covid19murcia/visera-covid19-diy/README.md

# visera-covid19-diy
Esta es una visera para ayudar a evitar salpicaduras que propaguen el covid19

En la carpeta diseño tenemos un diseño stl y en Freecad.
