covid19murcia/visera-covid19-diy/v0.4 con cintas.PNG

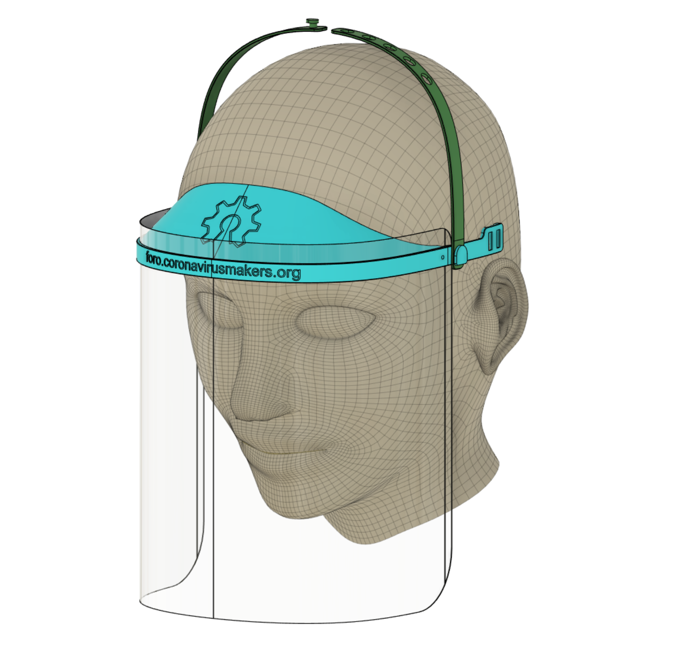
v0.4 con cintas.PNG
