covid19murcia/visera-covid19-diy/diseños/version03/Visera_3.5.1b_patas_traseras_recortadas.stl

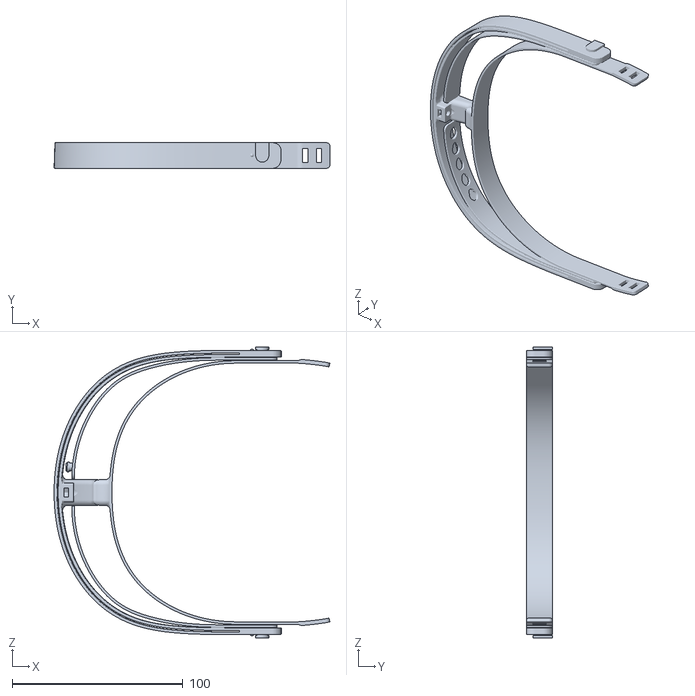
[picture p2: CAD file, 2020-03-18]
diseños/version03/Visera_3.5.1b_patas_traseras_recortadas.stl
161.5 x 15.0 x 170.4
