covid19murcia/visera-covid19-diy/diseños/version0.4/Fijador láminas finas/Fijador laminas finas 500um.stl

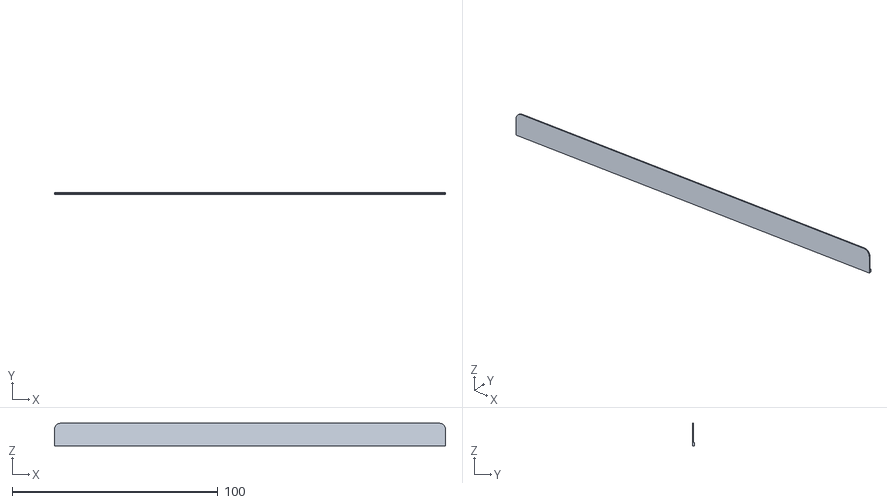
[picture p3: CAD file, 2020-03-21, an earlier design]
diseños/version0.4/Fijador láminas finas/Fijador laminas finas 500um.stl
190.0 x 1.20 x 11.0
