covid19murcia/visera-covid19-diy/diseños/version0.4/Visera_Fija_Cerrado_v0.4.stl

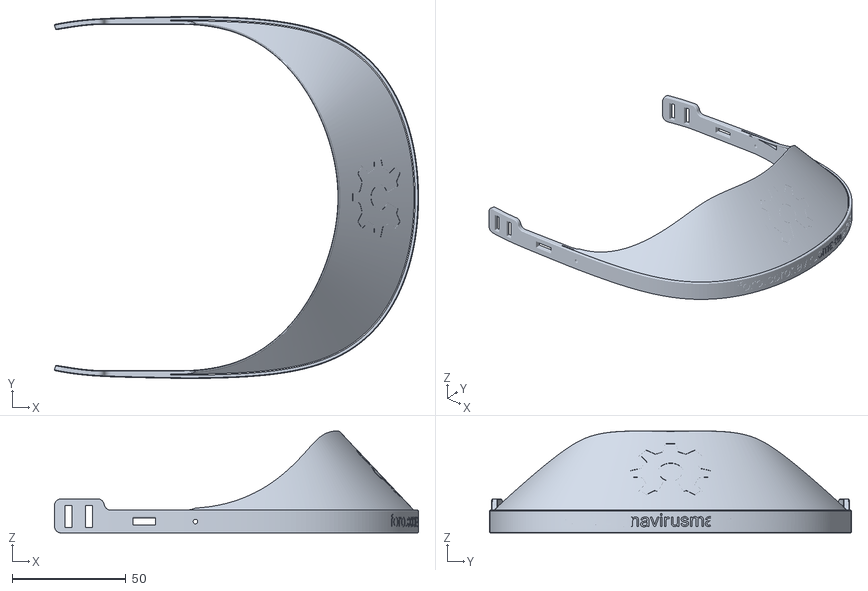
[picture p4: CAD file, 2020-03-21, an earlier design]
diseños/version0.4/Visera_Fija_Cerrado_v0.4.stl
159.9 x 159.0 x 44.8
