covid19murcia/visera-covid19-diy/diseños/version0.5/Visera_Plana_con_cierre_y_ventilacion_0.5.stl

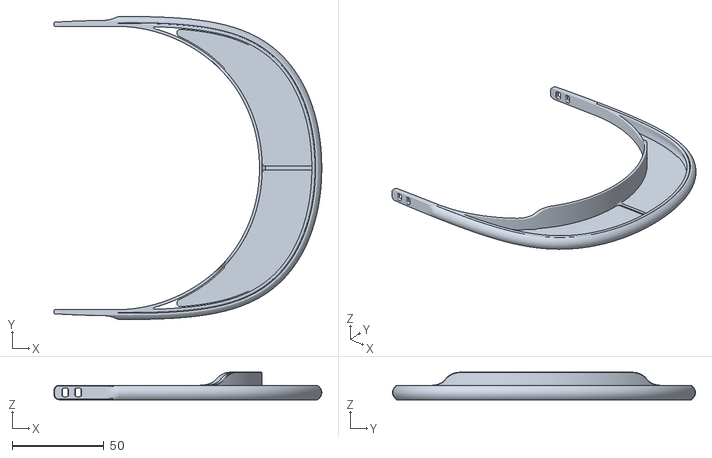
[picture p5: CAD file, 2020-03-23, an earlier design]
diseños/version0.5/Visera_Plana_con_cierre_y_ventilacion_0.5.stl
145.6 x 164.8 x 15.0
