covid19murcia/visera-covid19-diy/diseños/version0.4/Fijador láminas finas/Fijador laminas finas 600um.stl

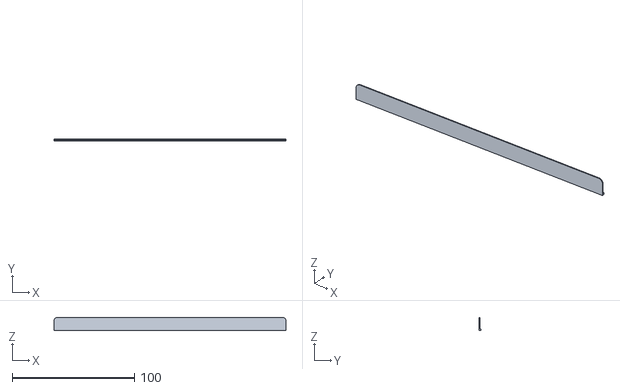
[picture p6: CAD file, 2020-03-21, an earlier design]
diseños/version0.4/Fijador láminas finas/Fijador laminas finas 600um.stl
190.0 x 1.50 x 11.0
