covid19murcia/visera-covid19-diy/(list of files, cad)

Other CAD files:
diseños/version0.4/Fijador láminas finas/Fijador laminas finas 400um.stl
diseños/version0.4/Fijador láminas finas/Fijador laminas finas 300um.stl
