covid19murcia/visera-covid19-diy/instrucciones/Visera Fija Cerrada rev0.4.pdf

# Visera Fija Cerrada rev0.4

### Compatible con Acetato A4 entre 0.18 y 0.6mm

### Dos variantes:

1. Totalmente fija | 2. Con cintas superiores móviles

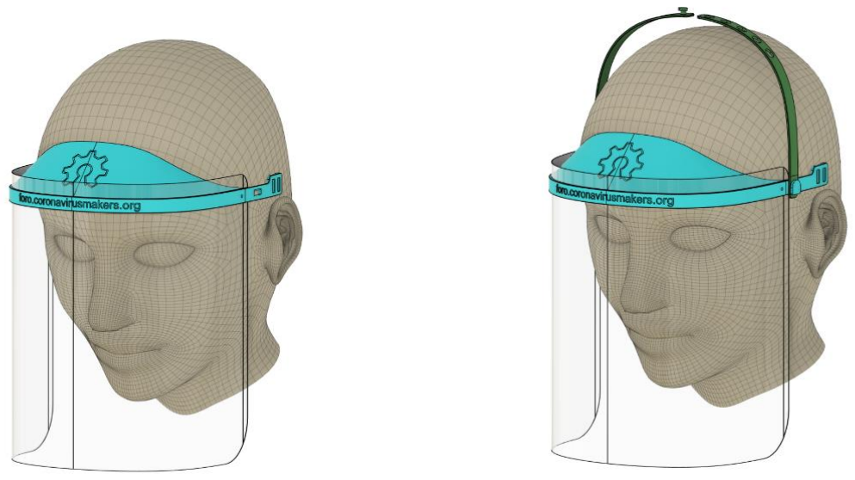
[picture p7: figure]
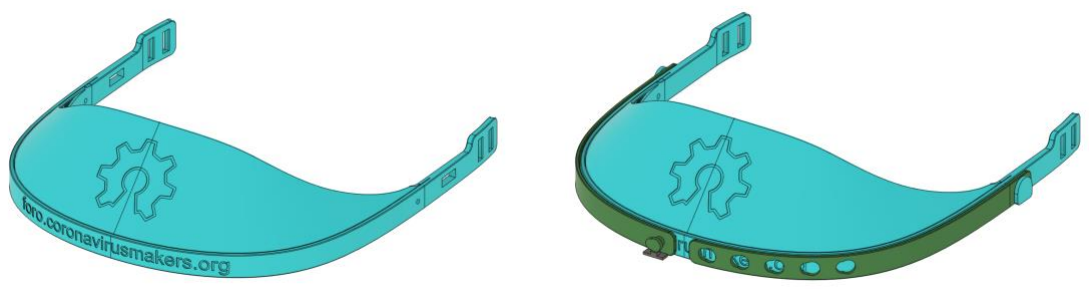
[picture p8: figure]

1h30min de impresión 30g | 1h50min de impresión 37g

Parámetros de impresión:

- Diámetro del Nozzle: 0.4mm
- Altura de capa: 0.28mm
- Relleno: 50%
- Tipo de relleno: Rejilla
- Capas superiores: 4
- Capas inferiores: 2
- Sin soportes

Fijación de la lámina en la visera:

- Para láminas de 0.6 no hace falta fijación extra.
- Para láminas finas (0.24, 0.18mm) usar archivo adjunto “Fijador láminas finas”. Este modelo viene en distintos espesores para compensar los distintos grosores de lámina.
