covid19murcia/visera-covid19-diy/instrucciones/Manual de ensamblaje mascara protectora v03.pdf

# Manual de impresión y ensamblaje mascara protectora

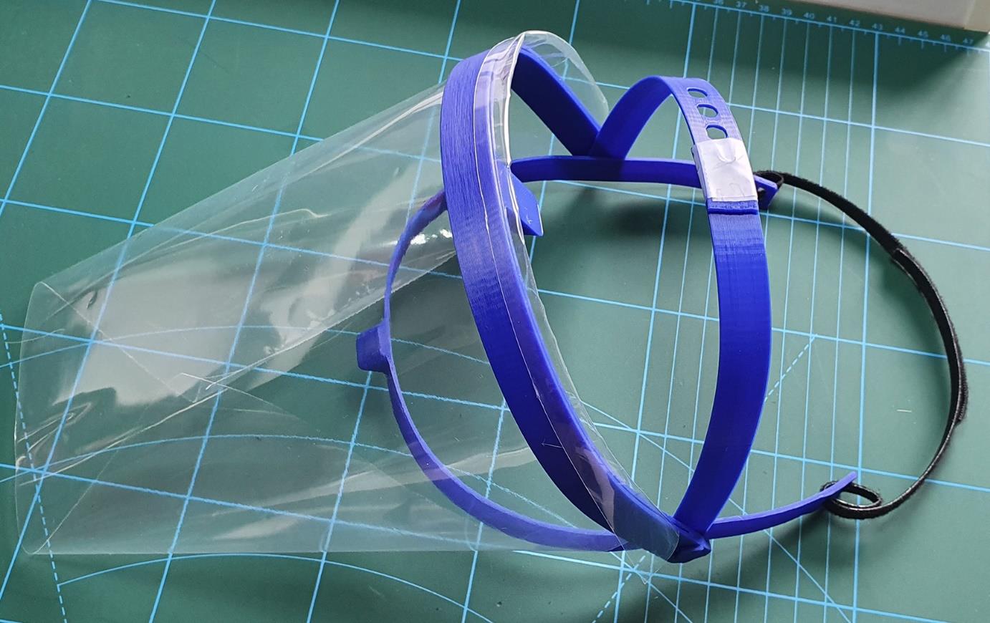
[picture p9: figure]

# Datos del Documento

Autor: | @YKA3D
Revisor: | @kermithenson
Fecha de publicación: | 18/03/2020

Observaciones:
Para comenzar a fabricar es necesario que la máquina esté correctamente calibrada. Una vez calibrada, se deberá llevar a cabo una prueba de tolerancia.

Test: https://www.thingiverse.com/thing:1662342

# Hoja de Cambios

Fecha | Versión | Autor | Cambios
18 de marzo de 2020 | v.0.1 | @YKA3D | Creación del documento
18 de marzo de 2020 | V.0.2 | @YKA3D | modificación fijación trasera
18 de marzo de 2020 | V.0.3 | @kermithenson

# Versión STL

Fecha | Versión | Autor | Cambios
18 de marzo de 2020 | v.3.5 | @YKA3D | Creación del documento

# Índice

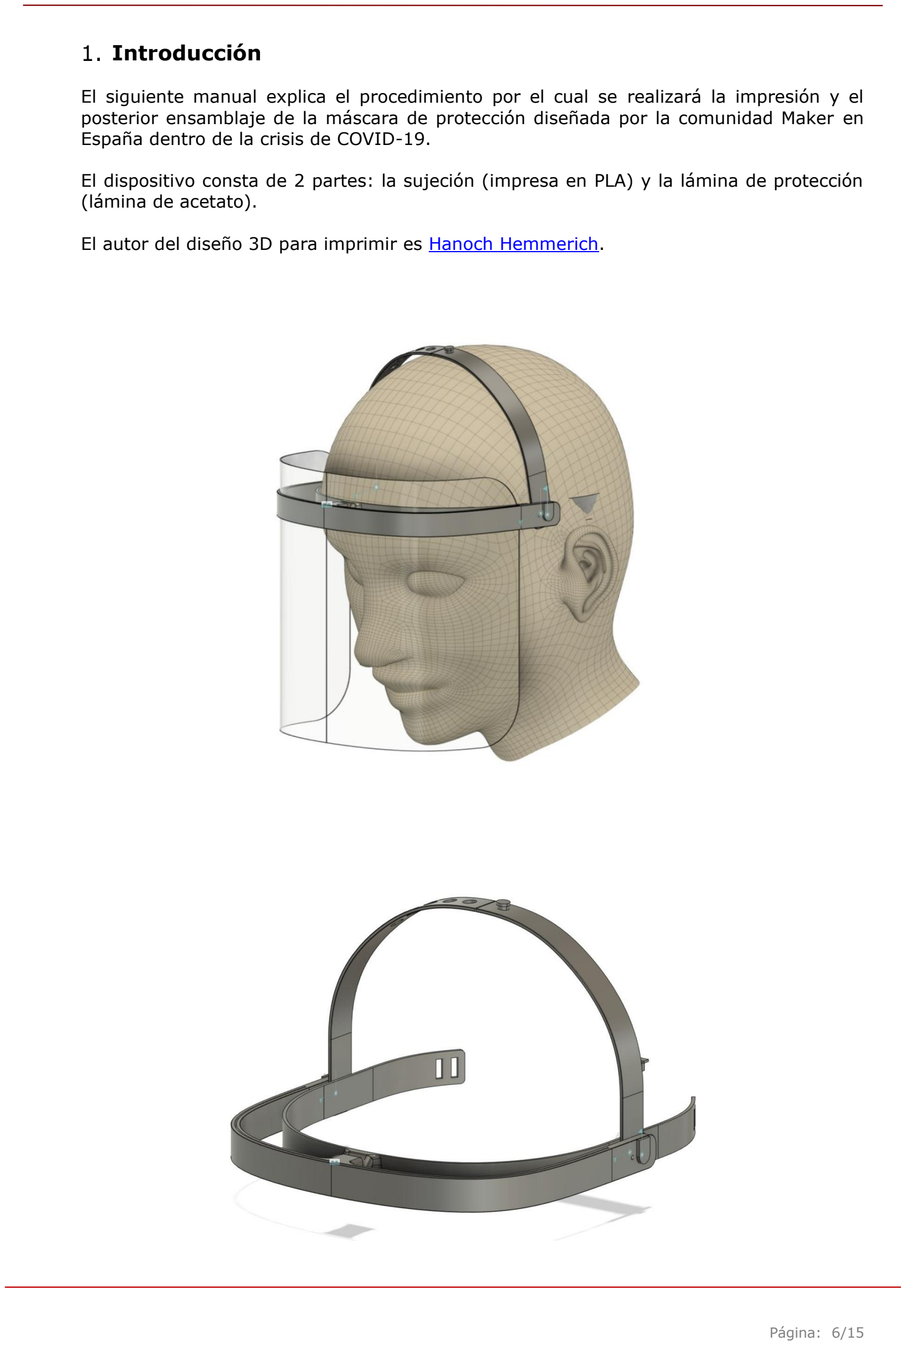
[picture p10: page 4]

### Introducción

El siguiente manual explica el procedimiento por el cual se realizará la impresión y el posterior ensamblaje de la máscara de protección diseñada por la comunidad Maker en España dentro de la crisis de COVID-19.

El dispositivo consta de 2 partes: la sujeción (impresa en PLA) y la lámina de protección (lámina de acetato).

El autor del diseño 3D para imprimir es Hanoch Hemmerich. (https://www.thingiverse.com/HanochH/about)

### Parámetros de impresión

El archivo para su impresión se puede descargar desde el siguiente enlace:

https://www.thingiverse.com/thing:4228123

- Diámetro del Nozzle: 0.4mm
- Altura de capa: 0.28mm
- Relleno: 50%
- Capas superiores: 4
- Capas inferiores: 2
- Flujo: 80%
- Sin soportes
- Velocidad de impresión:
- Perímetros: 80mm/s
- Perímetros pequeños: 80mm/s
- Perímetros externos: 80mms/s
- Relleno: 80mms/s
- Relleno solido: 80mms/s
- Relleno solido superior: 80mm/s
- Puentes: 80mm/s
- Relleno: 80mm/s
- Recorrido: 180mm/s

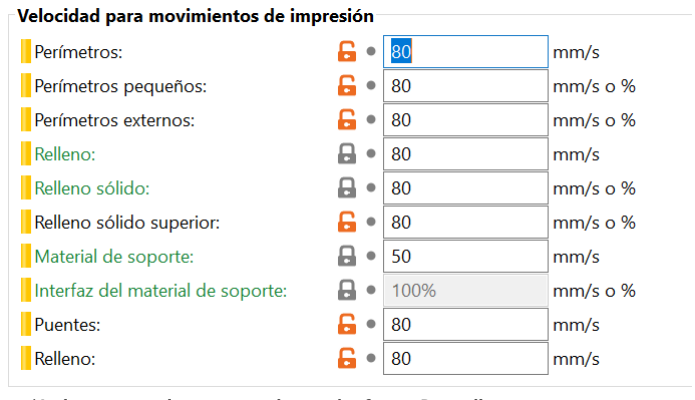
[picture p11: figure]

*La imagen anterior corresponde con el software Prusaslicer

Material impresión: PLA

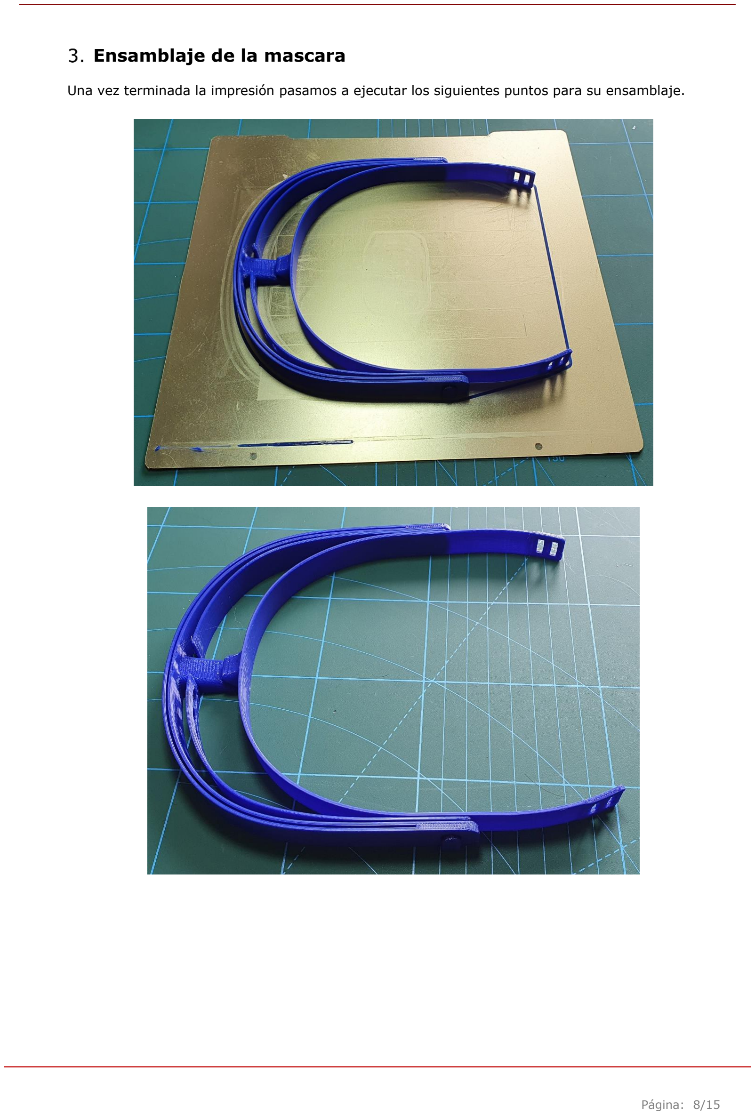
[picture p12: page 6]

### Ensamblaje de la mascara

Una vez terminada la impresión pasamos a ejecutar los siguientes puntos para su ensamblaje.

### Eliminación de soportes

El archivo ya viene preparado con un soporte para el remache que nos ayudara a fijar la correa superior para la cabeza.

Solo es necesaria la eliminación del pequeño soporte que se muestra en la siguiente imagen.

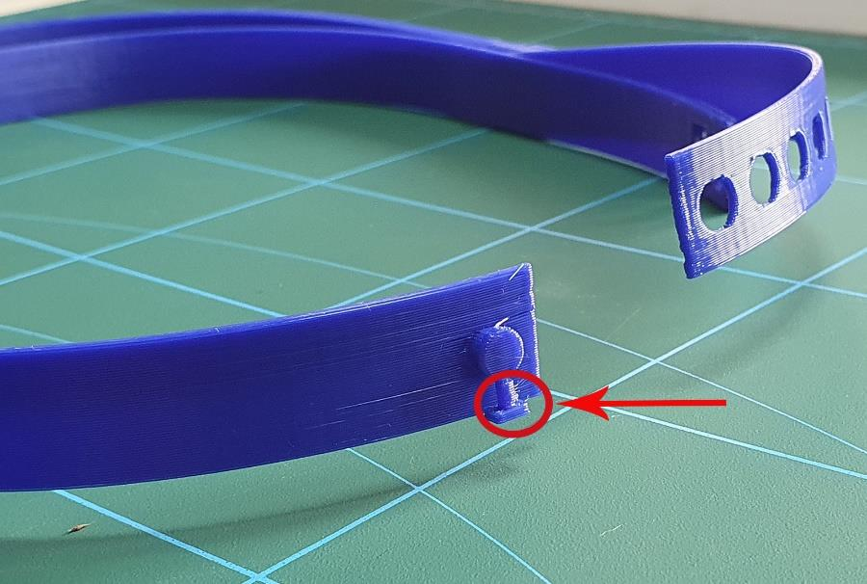
[picture p13: figure]

### Ajuste de correa para la cabeza

Una vez retirado el porte ajustamos la correa a la medida deseada

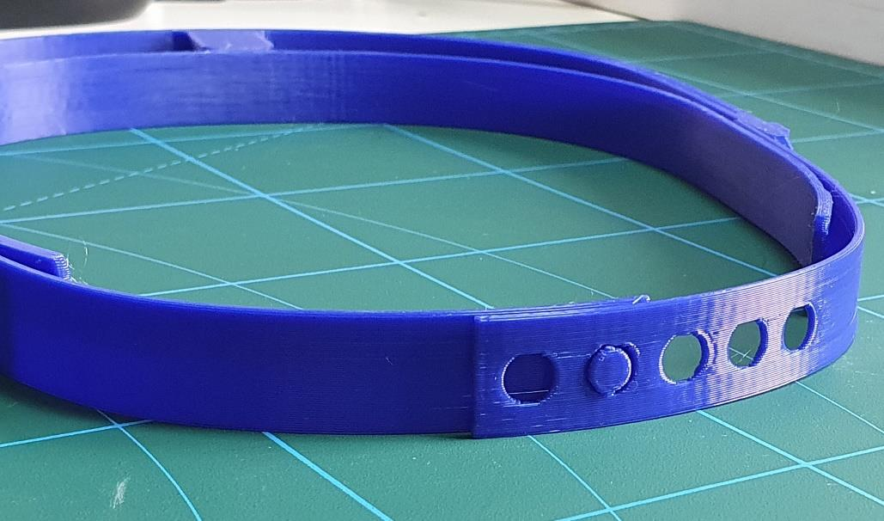
[picture p14: figure]

Cuando tengamos ajustada la correa superior para asegurarla es recomendable aplicar un poco de celo, esparadrapo, cinta, en definitiva, lo que se tenga a mano para sujetar con firmeza la correa superior.

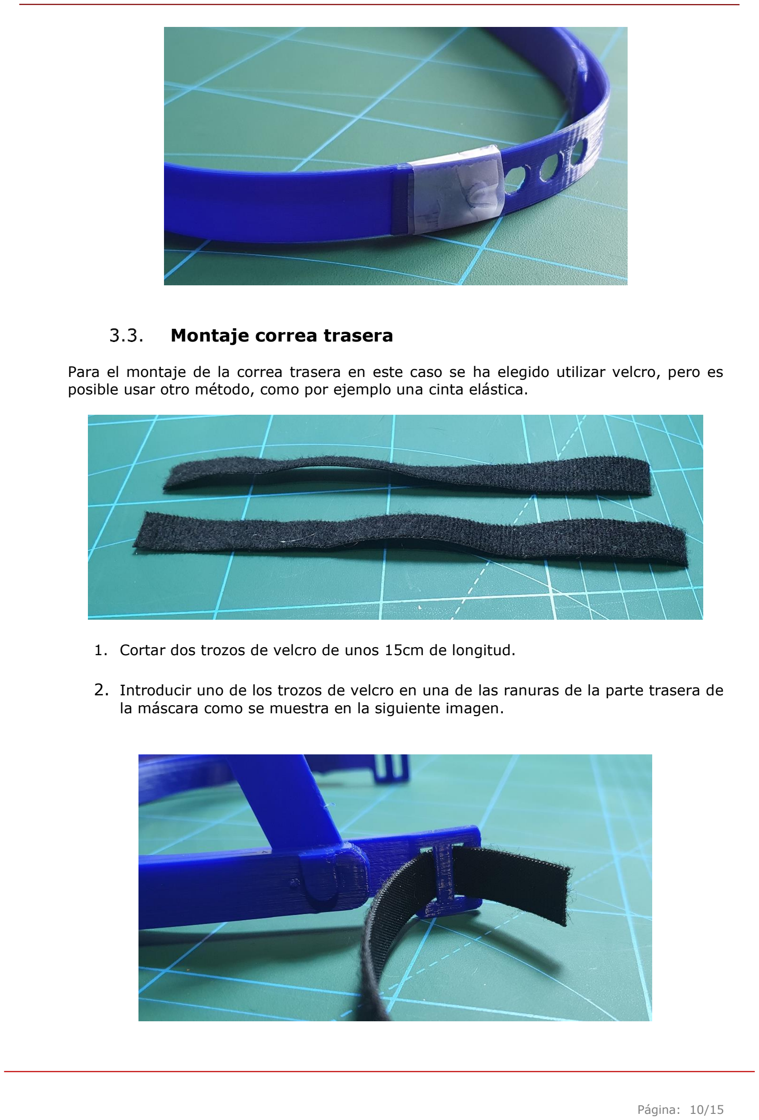
[picture p15: page 8]

### Montaje correa trasera

Para el montaje de la correa trasera en este caso se ha elegido utilizar velcro, pero es posible usar otro método, como por ejemplo una cinta elástica.

1. Cortar dos trozos de velcro de unos 15cm de longitud.
2. Introducir uno de los trozos de velcro en una de las ranuras de la parte trasera de la máscara como se muestra en la siguiente imagen.

3. Girar el extremo más corto del velcro para crear un bucle y que quede fijado en una de las patillas, tal como se muestra en la siguiente imagen. (Importante que la parte del velcro suave quede hacia afuera)

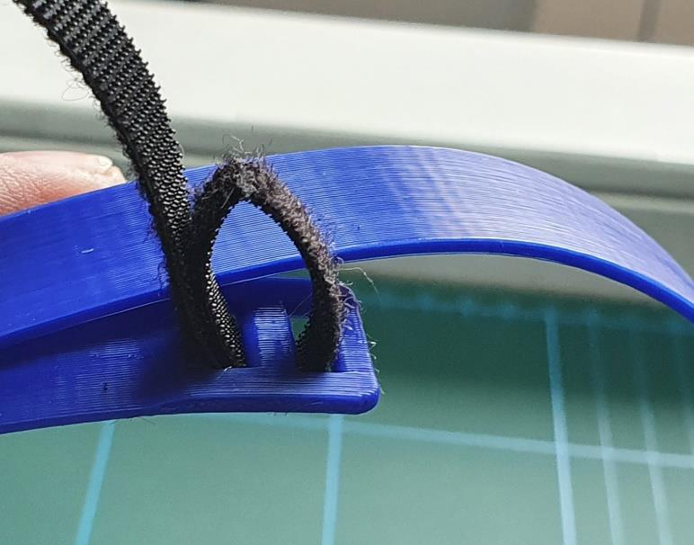
[picture p16: figure]

4. Girar un poco el velcro para que dé un par de vueltas y quede bien fijado

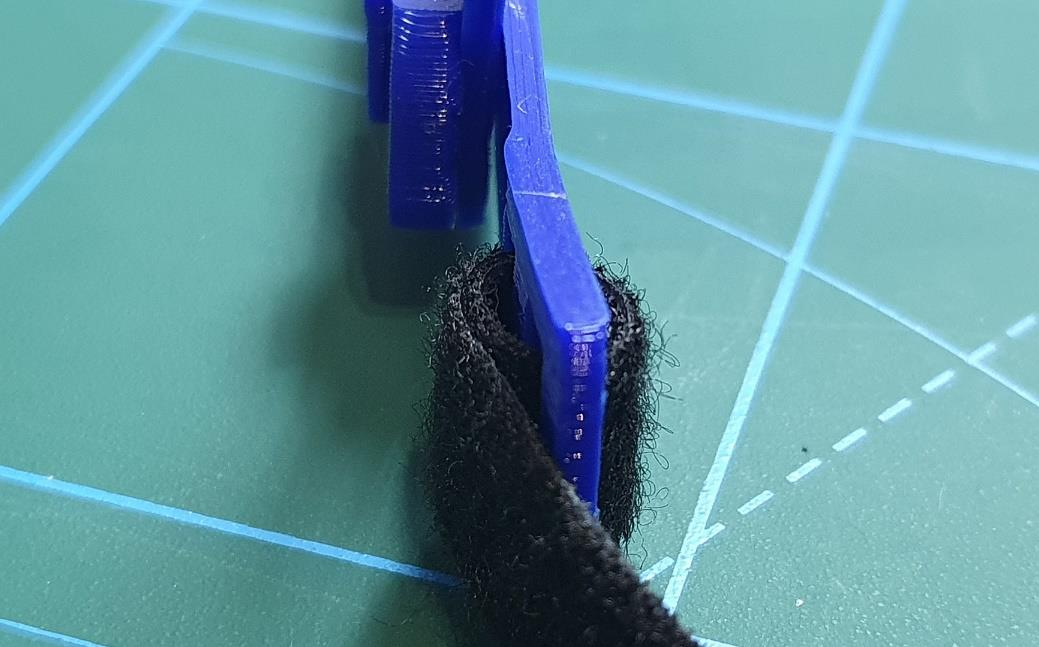
[picture p17: figure]

5. Repetimos el proceso con la otra patilla.
6. El resultado final tiene que ser el de la imagen siguiente:

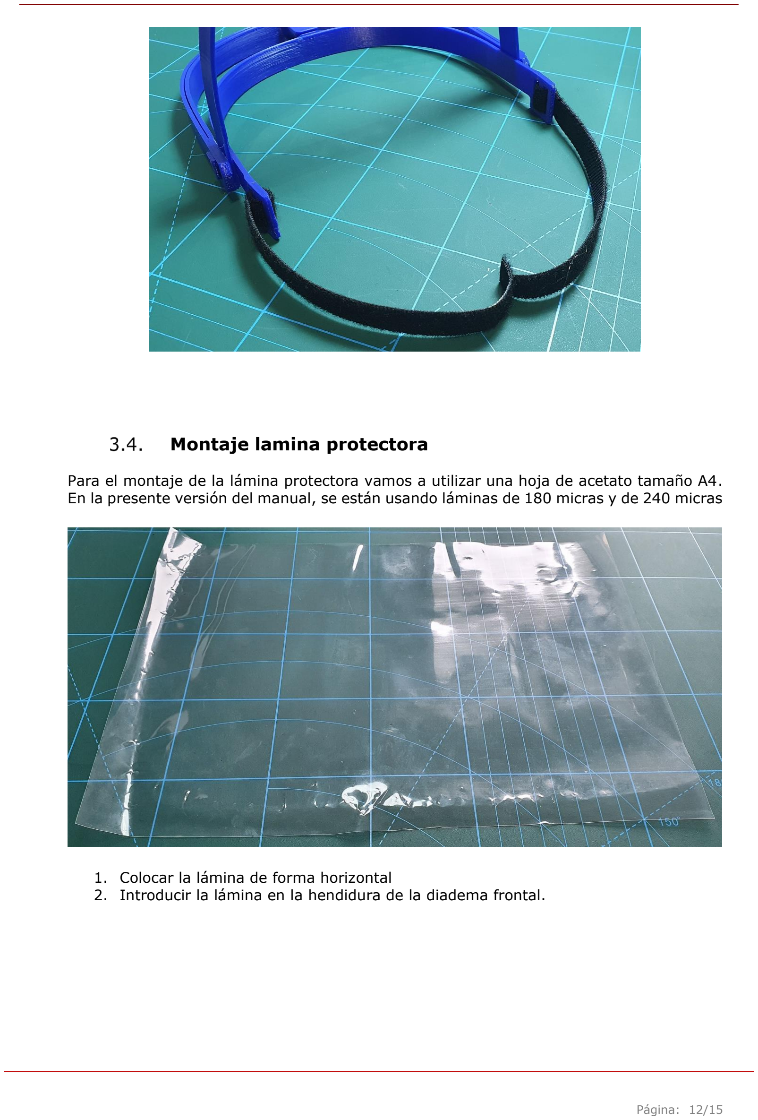
[picture p18: page 10]

### Montaje lamina protectora

Para el montaje de la lámina protectora vamos a utilizar una hoja de acetato tamaño A4. En la presente versión del manual, se están usando láminas de 180 micras y de 240 micras

1. Colocar la lámina de forma horizontal
2. Introducir la lámina en la hendidura de la diadema frontal.

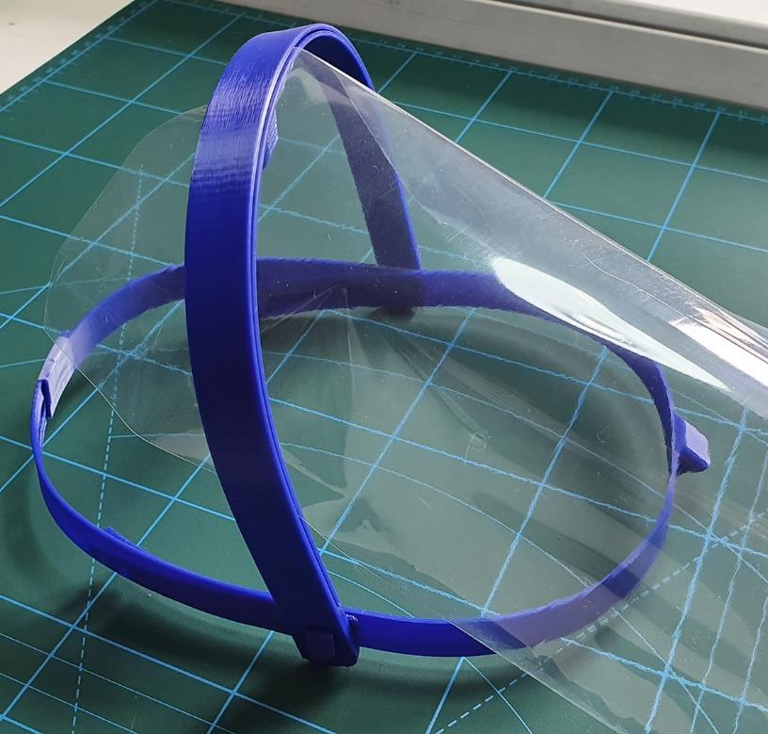
[picture p19: figure]
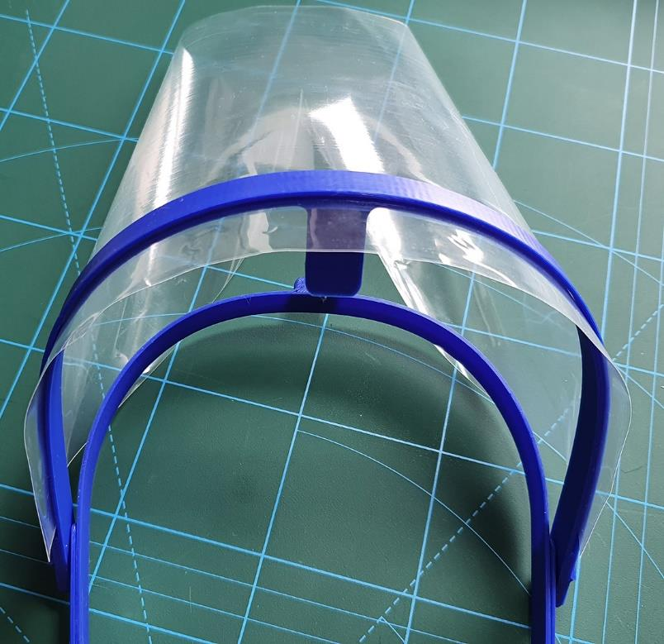
[picture p20: figure]
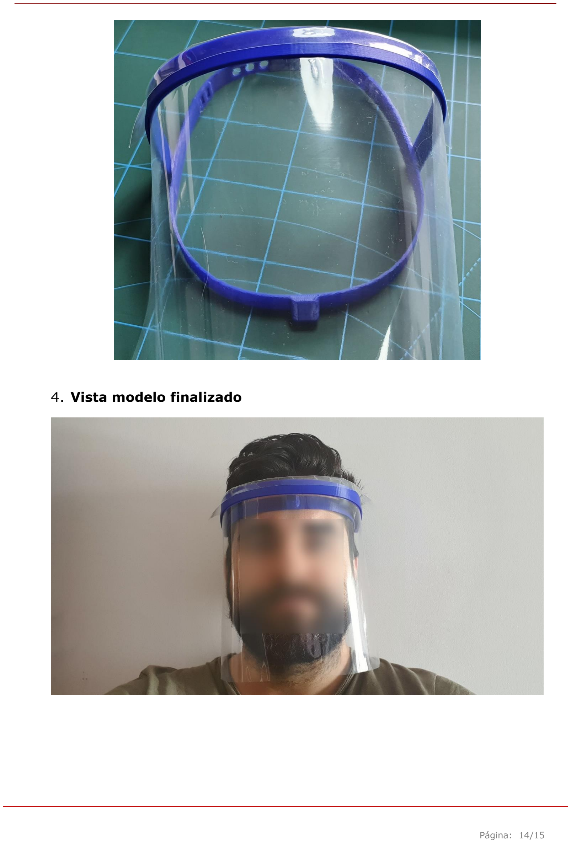
[picture p21: page 12]

### Vista modelo finalizado

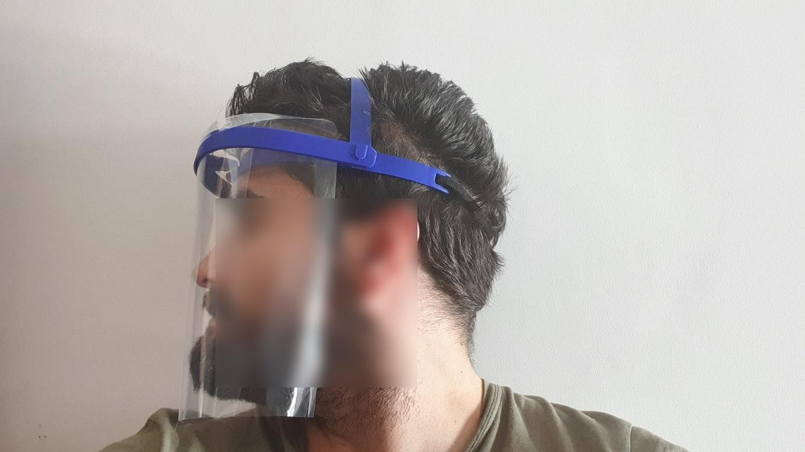
[picture p22: figure]
