covid19murcia/visera-covid19-diy/(commit log)

2020-03-18 subidos los primeros diseños de la visera
    [Visera_3.5.1b_patas_traseras_recortadas.stl]
2020-03-19 subida fichero de instrucciones para la visera
2020-03-21 nuevo diseño version 0.4
    [Fijador laminas finas 300um.stl, Fijador laminas finas 400um.stl, Fijador laminas finas 500um.stl, Fijador laminas finas 600um.stl, Visera_Fija_Cerrado_v0.4.stl]
2020-03-23 añadido version 0.5
    [Visera_3.5.1b_patas_traseras_recortadas.stl, Visera_Plana_con_cierre_y_ventilacion_0.5.stl]
